redc6t/Sentinel/Hardware/BTTM_v1.2_BOM.xlsx

Qty | Description | Designators | Package | Value | MPN | Manufacturer | Comments
ICs
1 | IC REG BUCK 3.3V 3.5A 20SWTQFN | U1 | 21-100318A_T2044Y+5C_MXM |  | MAX25223ATPB/VY+ | Analog Devices Inc.
1 | RF TXRX MOD BT WIFI PCB TH SMD | U2 | 41-SMD Module |  | ESP32-S3-WROOM-2-N16R8V | Espressif Systems | DNP
1 | IC TRANSCEIVER HALF 1/1 8SOIC | U3 | 8-SOIC |  | TCAN3413DR | Texas Instruments
1 | RF RCVR GNSS/GPS 1.575GHZ 24LCC | U4 | 24-SMD Module |  | NEO-M8M-0 | uBlox | DNP
Capacitors
2 | CAP CER 2.2UF 50V X7R 1206 | C1, C2 | CAPC3216 (1206) | 2.2uF | GCJ31CR71H225KA12L | Murata
4 | CAP CER 0.1UF 100V X7R 0603 | C3, C13, C14, C18 | CAPC1608 (0603) | 100nF | GRM188R72A104KA35D | Murata
2 | CAP CER 1UF 10V X5R 0603 | C4, C15 | CAPC1608 (0603) | 1uF | GRM188R61A105KA61D | Murata
2 | CAP CER 22UF 10V X7R 1206 | C5, C6 | CAPC3216 (1206) | 22uF | GRM31CR71A226KE15L | Murata
4 | CAP ALUM 100UF 20% 6.3V SMD | C7, C8, C9, C10 | Radial, Can - SMD (6.30 x 5.80) | 100u - 35V | EEE-FP0J101AP | Panasonic
1 | CAP CER 10UF 6.3V X5R 0603 | C16, C19 | CAPC1608 (0603) | 10uF | GRM188R60J106KE47D | Murata
1 | CAP CER 10000PF 100V X7R 0603 | C17 | CAPC1608 (0603) | 10nF | GRM188R72A103KA01D | Murata
Resistors
2 | RES 1K OHM 1% 1/10W 0603 | R1, R13 | RCL_R0603 | 1k | RC0603FR-071KL | Yageo
10 | RES 10K OHM 1% 1/10W 0603 | R2, R3, R4, R5, R6, R7, R14, R15, R16, R17 | RCL_R0603 | 10k | RC0603FR-0710KL | Yageo
2 | RES 4.7K OHM 1% 1/10W 0603 | R8, R9 | RCL_R0603 | 4.7k | RC0603FR-074K7L | Yageo
2 | RES 0 OHM 1% 1/10W 0603 | R10, R11 | RCL_R0603 | 0R | RC0603FR-070RL | Yageo
1 | RES 10 OHM 1% 1/10W 0603 | R12 | RCL_R0603 | 10R | RC0603FR-0710RL | Yageo
Filters, Ferrites, Inductors, Fueses
1 | PTC RESET FUSE 60V 550MA 2018 | F1 | FUSE_SMDF050-2 |  | MF-SMDF050-2 | Bourns Inc.
1 | FIXED IND 8.2UH 2A 180 MOHM SMD | L1 | 2-SMD | 8.20uH | SRP4020TA-8R2M | Bourns Inc.
1 | FIXED IND 27NH 300MA 700MOHM SMD | L2 | 0603 (1608 Metric) | 27.0nH | LRC0603CJ27NGV001T | Johanson Technology Inc.
1 | TRANS NPN 40V 1A SOT-323 | Q1 | SOT-323 |  | PBSS4140U,115 | Nexperia USA Inc.
Mechanical
1 | 3 PINS, PANEL MOUNT,Rear FASTE | J1 | CUI_CDM801-03A-MP-F810-67 |  | CDM801-03A-MP-F810-67 | Same Sky
2 | 4 PINS, PANEL MOUNT,Rear FASTE | J2, J12 | CUI_CDM803-04A-FP-R805-67 |  | CDM803-04A-FP-R805-67 | Same Sky
1 | Micro SD Card Holder Pcb Mount | SD | MICROSD-PUSH-OUT |  |  | AliExpress
1 | CONN U.FL RCPT STR 50 OHM SMD | J21 | U.FL |  | U.FL-R-SMT-1(80) | Hirose Electric Co Ltd
1 | Battery Recharge RTC/SRAM Backup | BT1 | BATTCON-6.8MM | 3V - 5.5 mAh | MS621FE-FL11E | Seiko Instruments | DNP
1 | CONN HEADER SMD 6POS 1.27MM | PROG | Conn Header SMT 6 pos 1.27mm |  | FTSH-103-01-L-DV-TR | Samtec Inc. | DNP
1 | 3.2' Module ILI9341 320*240 SPI | 3.2 DISPLAY |  |  |  | AliExpress | DNP
Diodes, TVSs, Schottkys
1 | DIODE SCHOTTKY 40V 5A SMC | D1 | DIOM7959X261N |  | MBRS540T3G | onsemi
1 | TVS DIODE 24VWM 37VC SC703 | D3 | SOT-323 |  | ESD2CAN24DCKRQ1 | Texas Instruments
1 | Single Colour LEDs WL-SMCW SMD | D5 | LED-1206-BOTTOM |  | 150060SS75000 | Wurth Elektronik | Optional
