redc6t/Sentinel/Hardware/Enclosure/Sentinel_Top_Enclosure_1.4.step

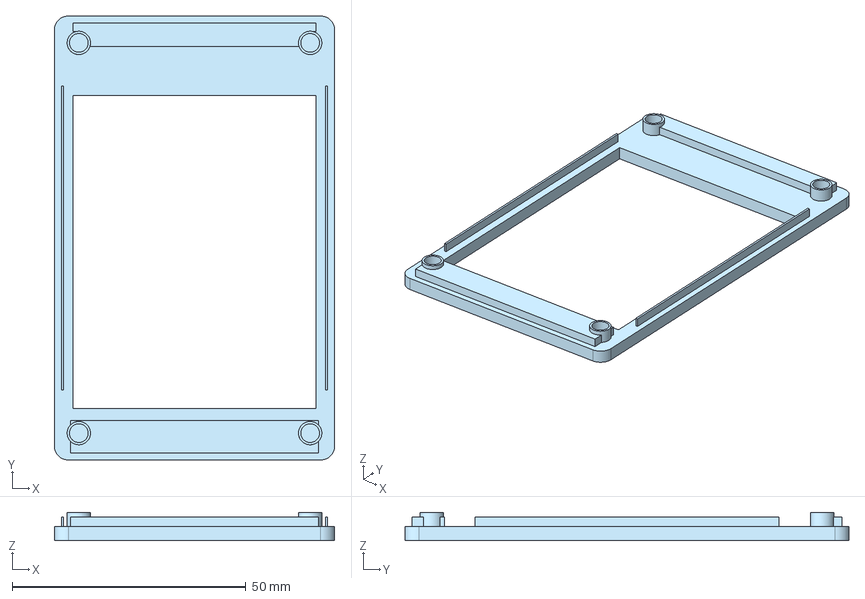
[picture p3: CAD file, 2026-10-24]
Hardware/Enclosure/Sentinel_Top_Enclosure_1.4.step
60.0 x 95.0 x 6.00 mm
