redc6t/Sentinel/Hardware/PCB/3D/BTTM_v1.4.step

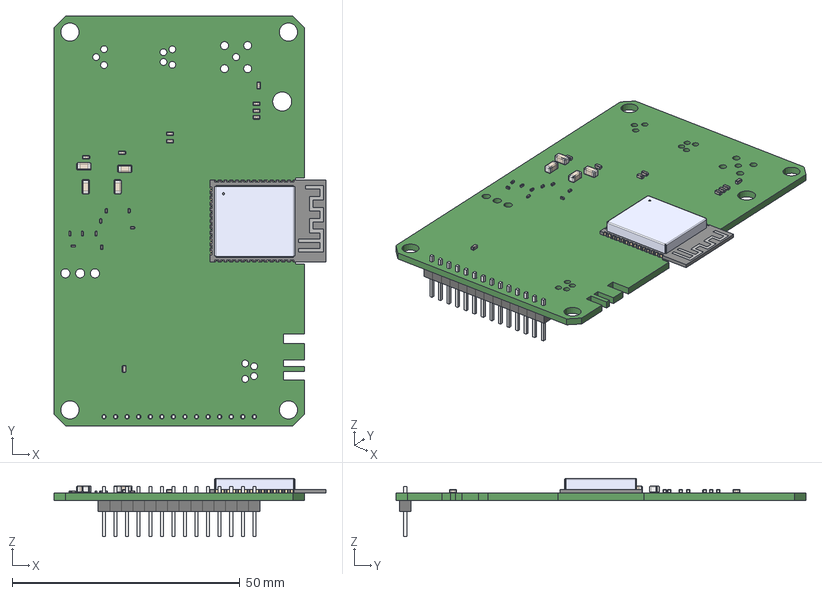
[picture p4: CAD file, 2026-10-17]
Hardware/PCB/3D/BTTM_v1.4.step
59.8 x 90.0 x 12.9 mm
PCB:1
3.2DISPLAY:1
C1:1
C2:1
C3:1
C4:1
C5:1
C6:1
C13:1
C14:1
C15:1
C16:1
C17:1
C18:1
C19:1
C21:1
C22:1
C51:1
C121:1
C122:1
C123:1
C124:1
C125:1
C131:1
U2:1
