redc6t/Sentinel/Hardware/Enclosure/Sentinel_Bottom_Enclosure_1.4.step

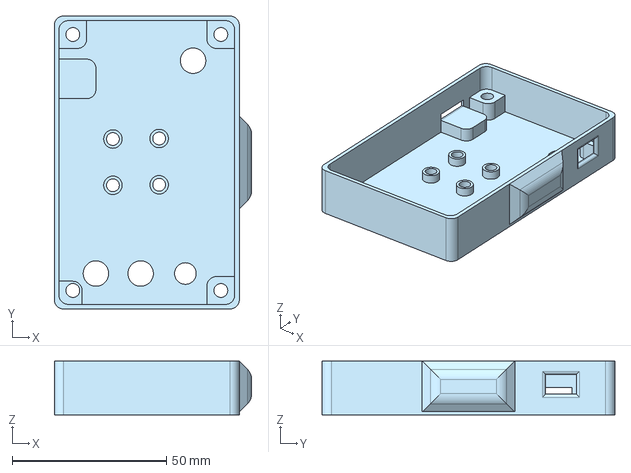
[picture p5: CAD file, 2026-10-24]
Hardware/Enclosure/Sentinel_Bottom_Enclosure_1.4.step
64.0 x 95.0 x 17.4 mm
