redc6t/Sentinel/Photos-Journal_Megadump/7) Full System Install on Alfa Romeo 156/IMG_2208.jpeg

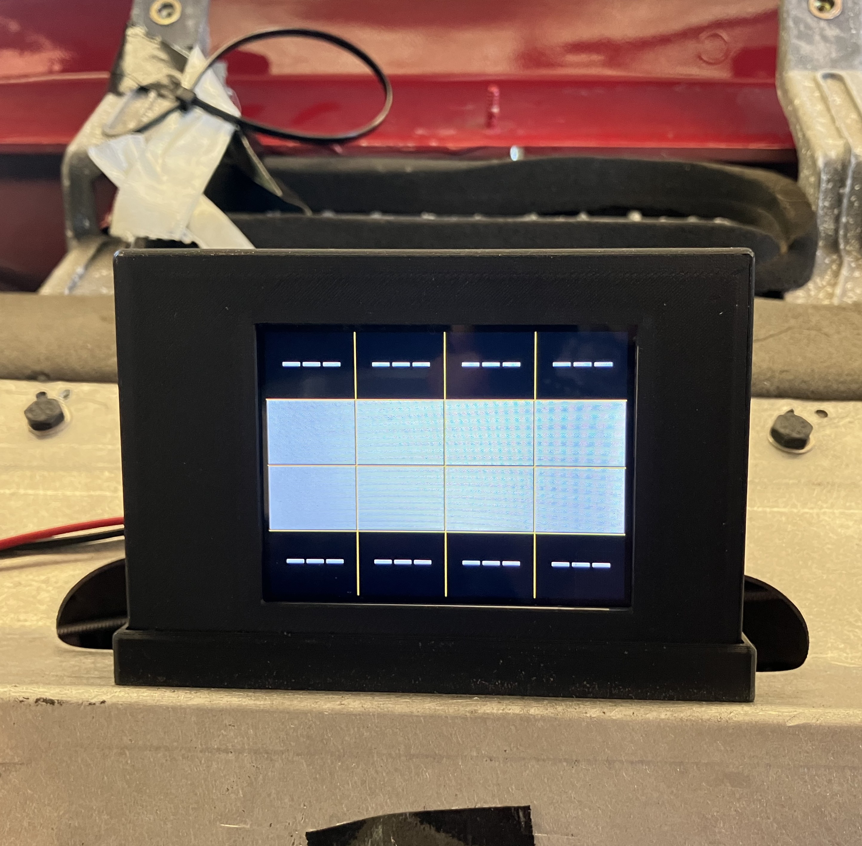
Photos-Journal_Megadump/7) Full System Install on Alfa Romeo 156/IMG_2208.jpeg
