redc6t/Sentinel/Photos-Journal_Megadump/8) 1.4 version photoshoot/IMG_3616.jpeg

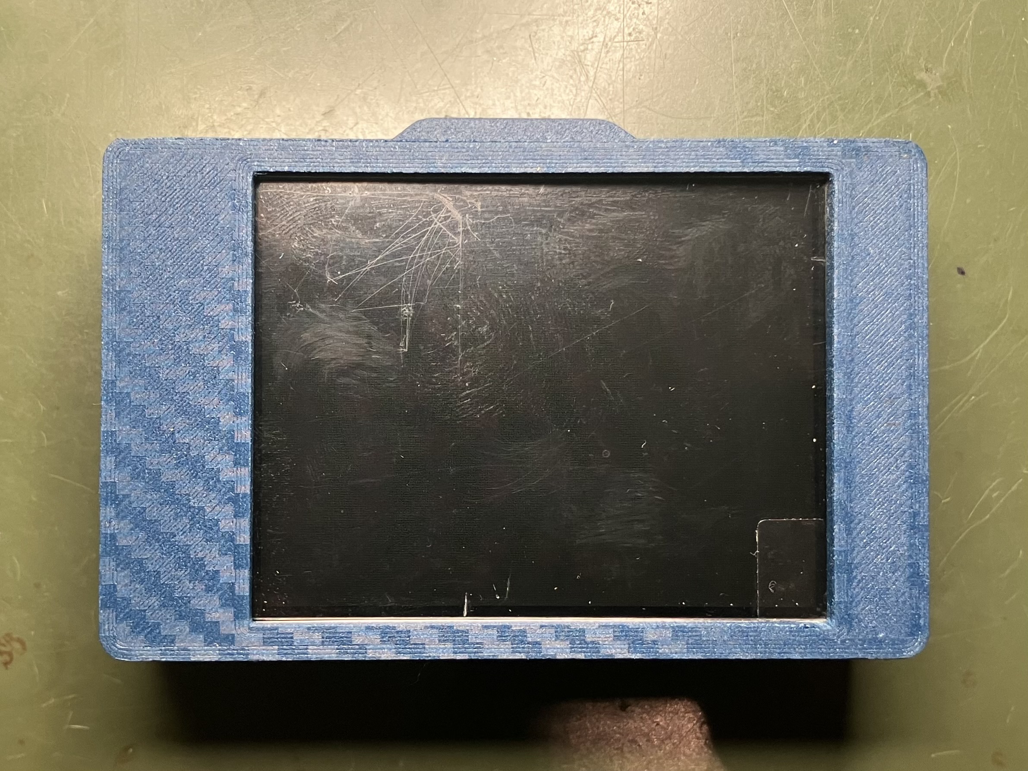
Photos-Journal_Megadump/8) 1.4 version photoshoot/IMG_3616.jpeg
