redc6t/Sentinel/Hardware/PCB/Board/BTTM_v1.4_Board.pdf

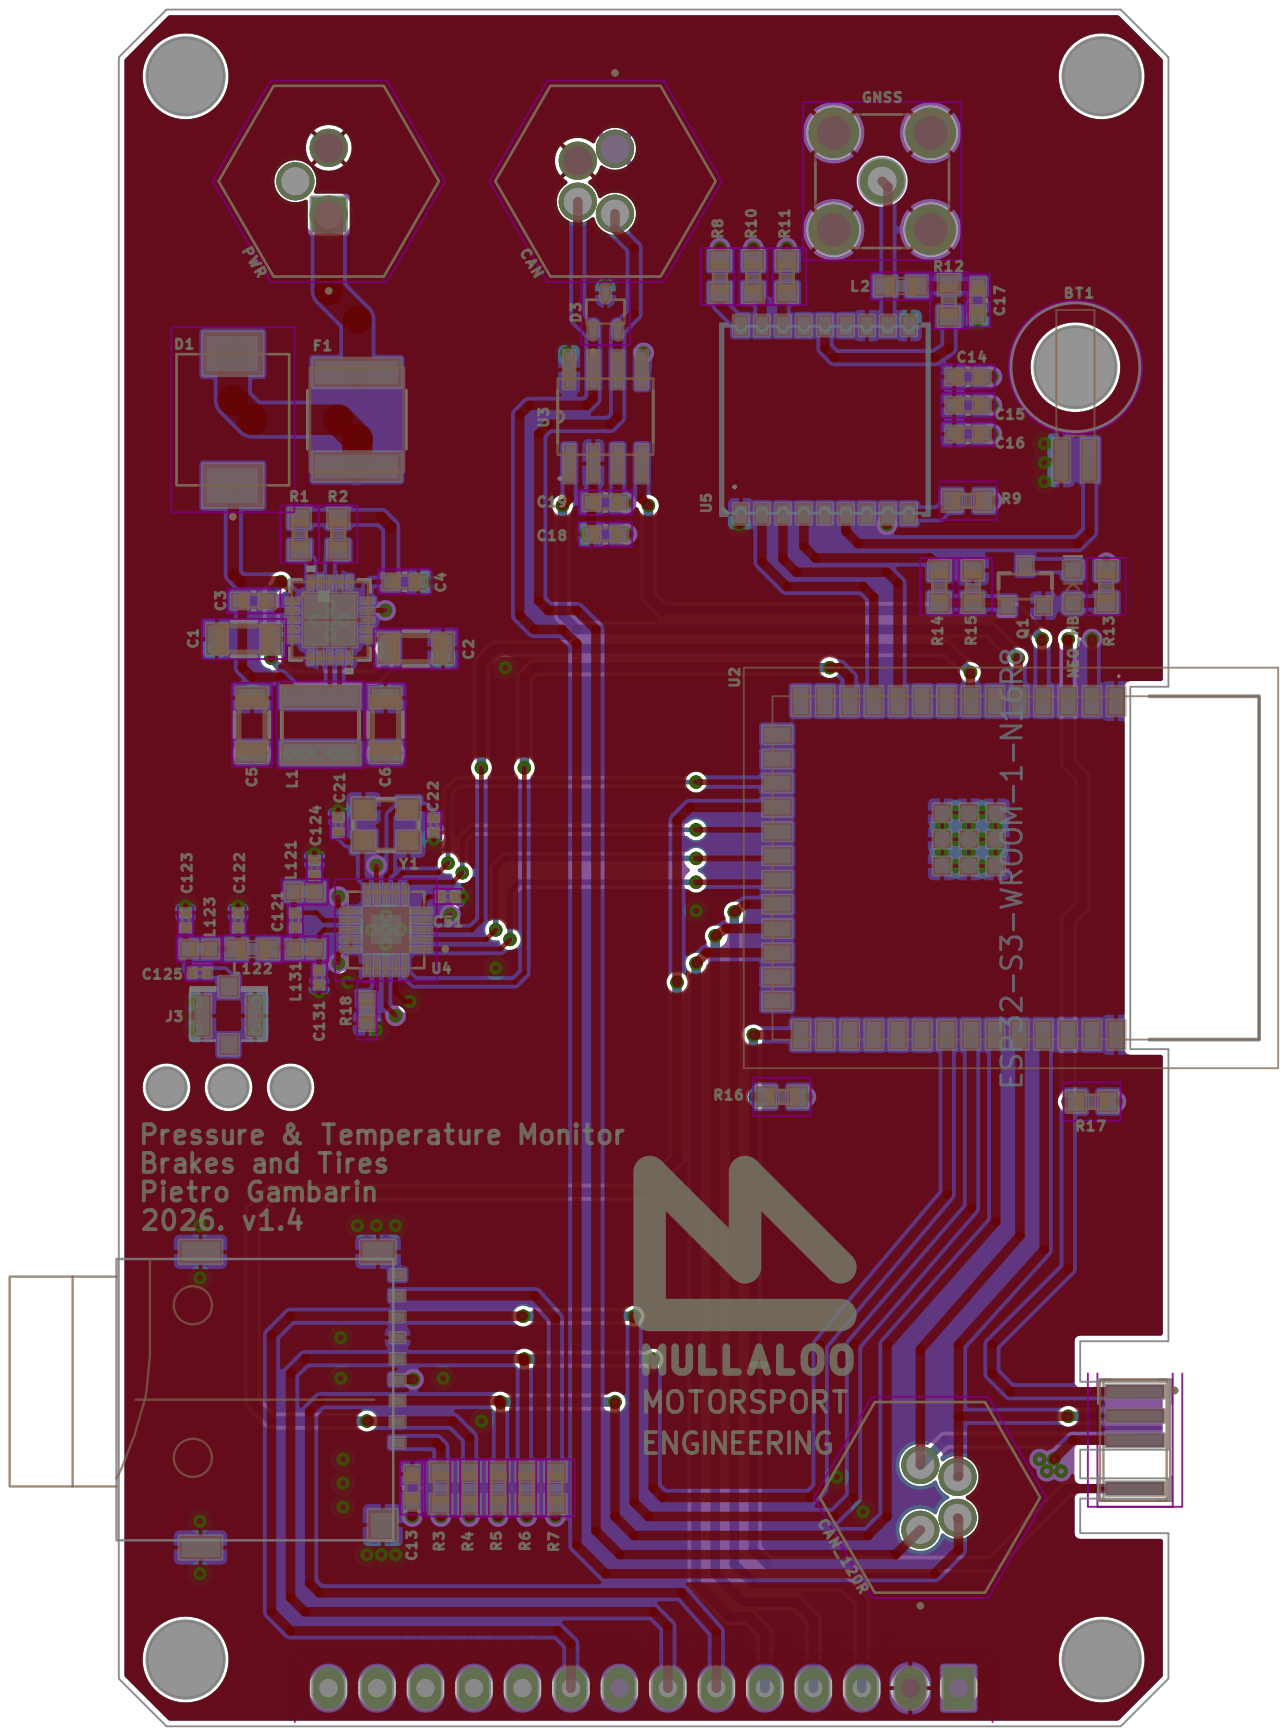
[picture p11: page 1]

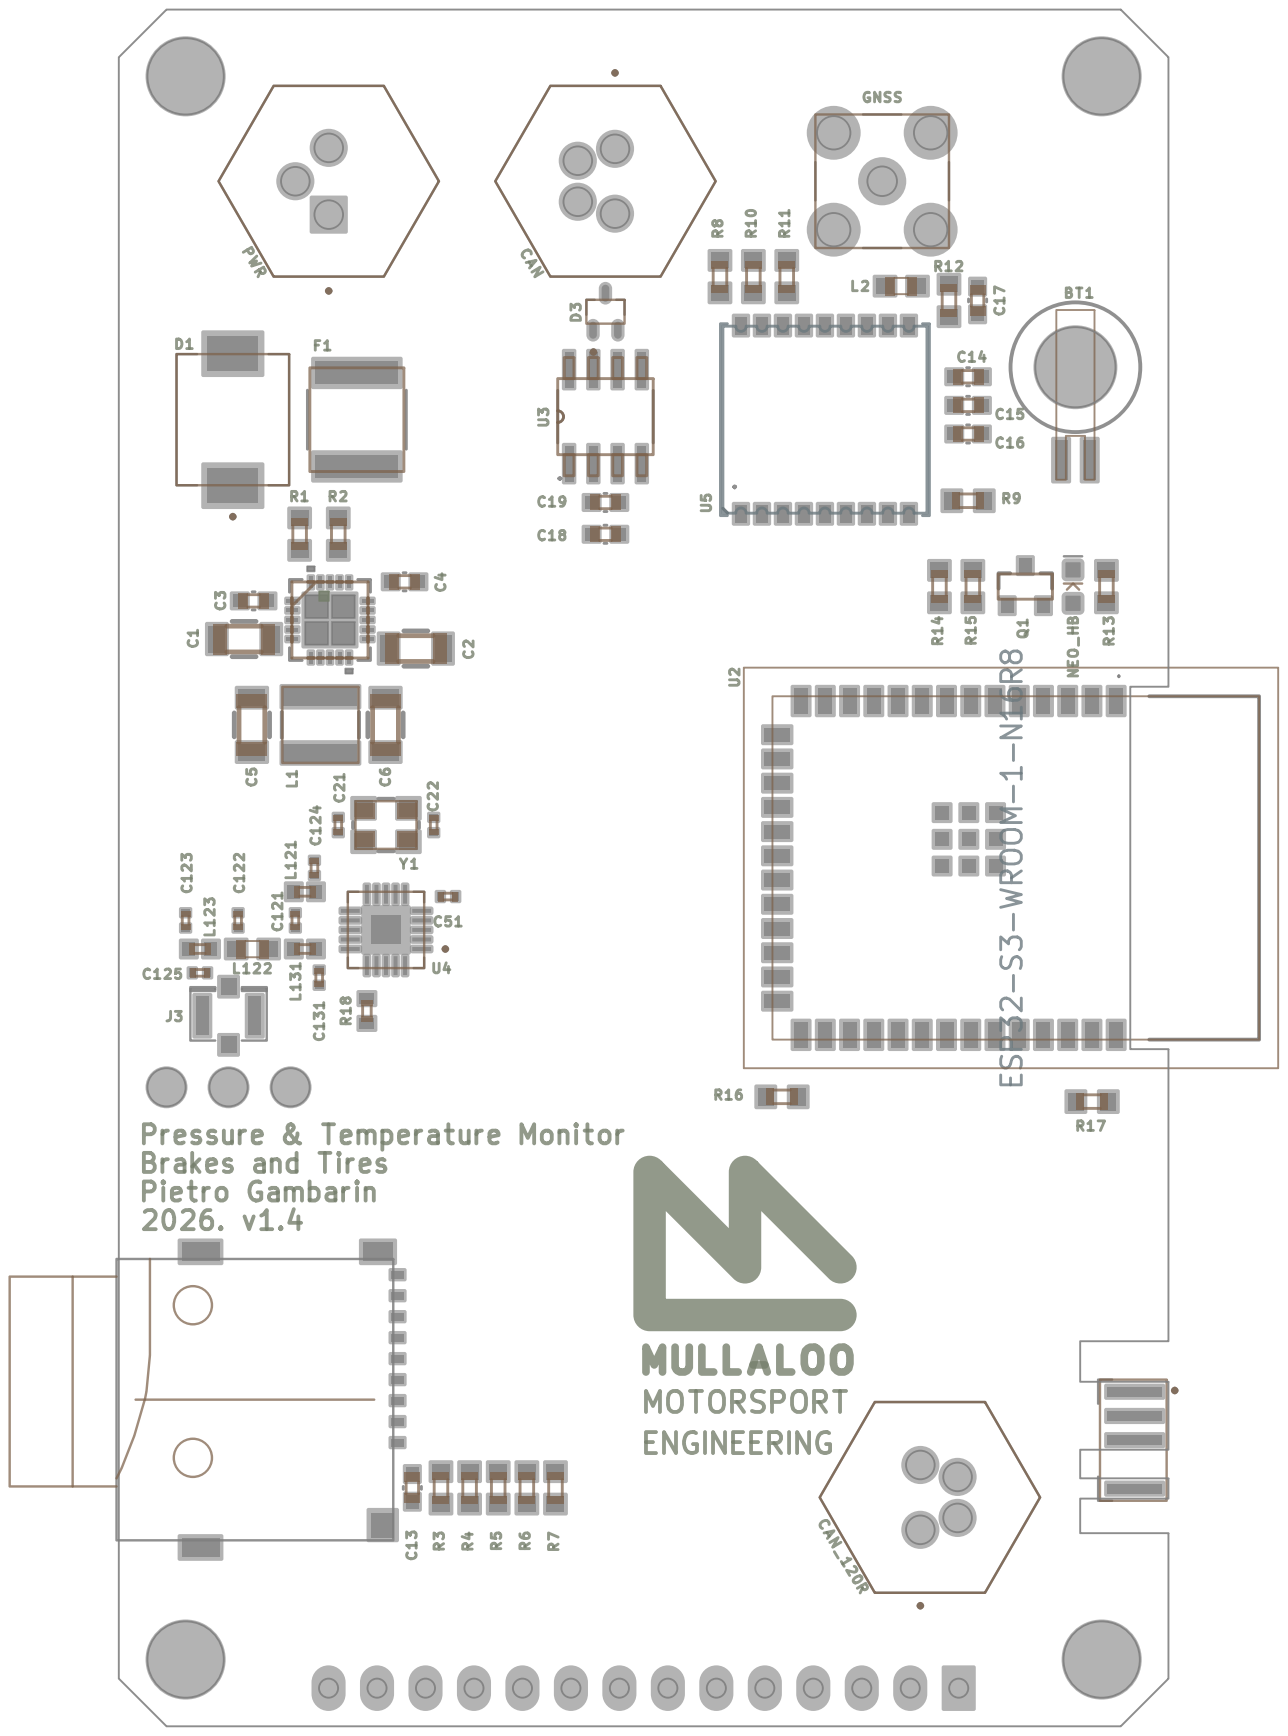
[picture p12: page 2]

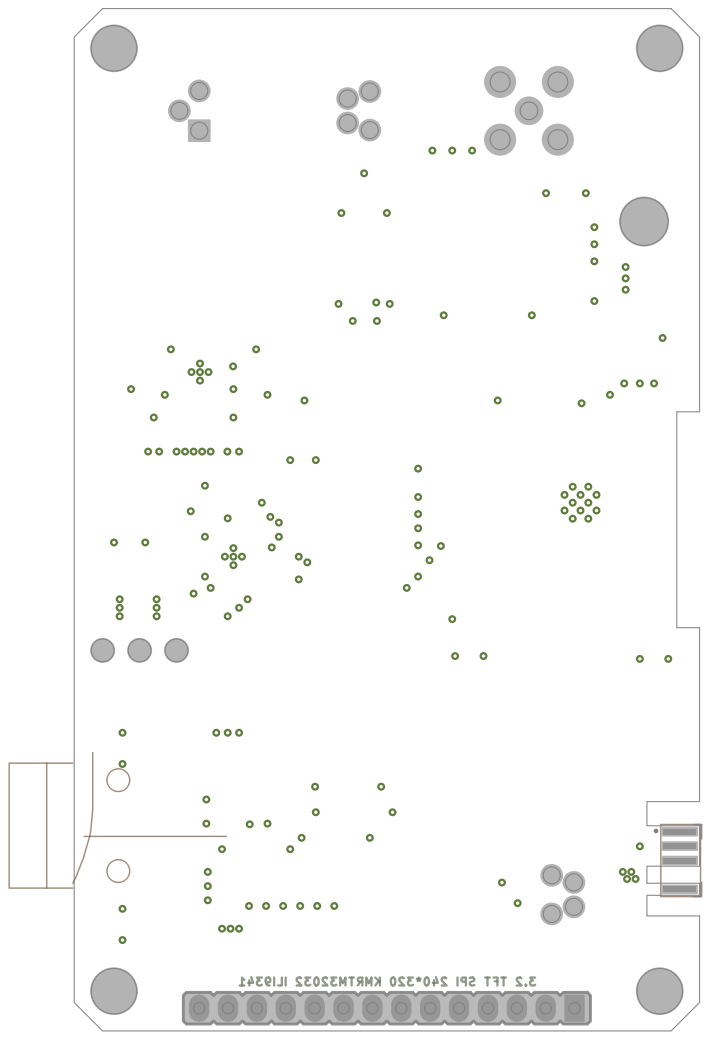
[picture p13: page 3]
3.2 TFT SPI 240*320 KMRTM32032 ILI9341

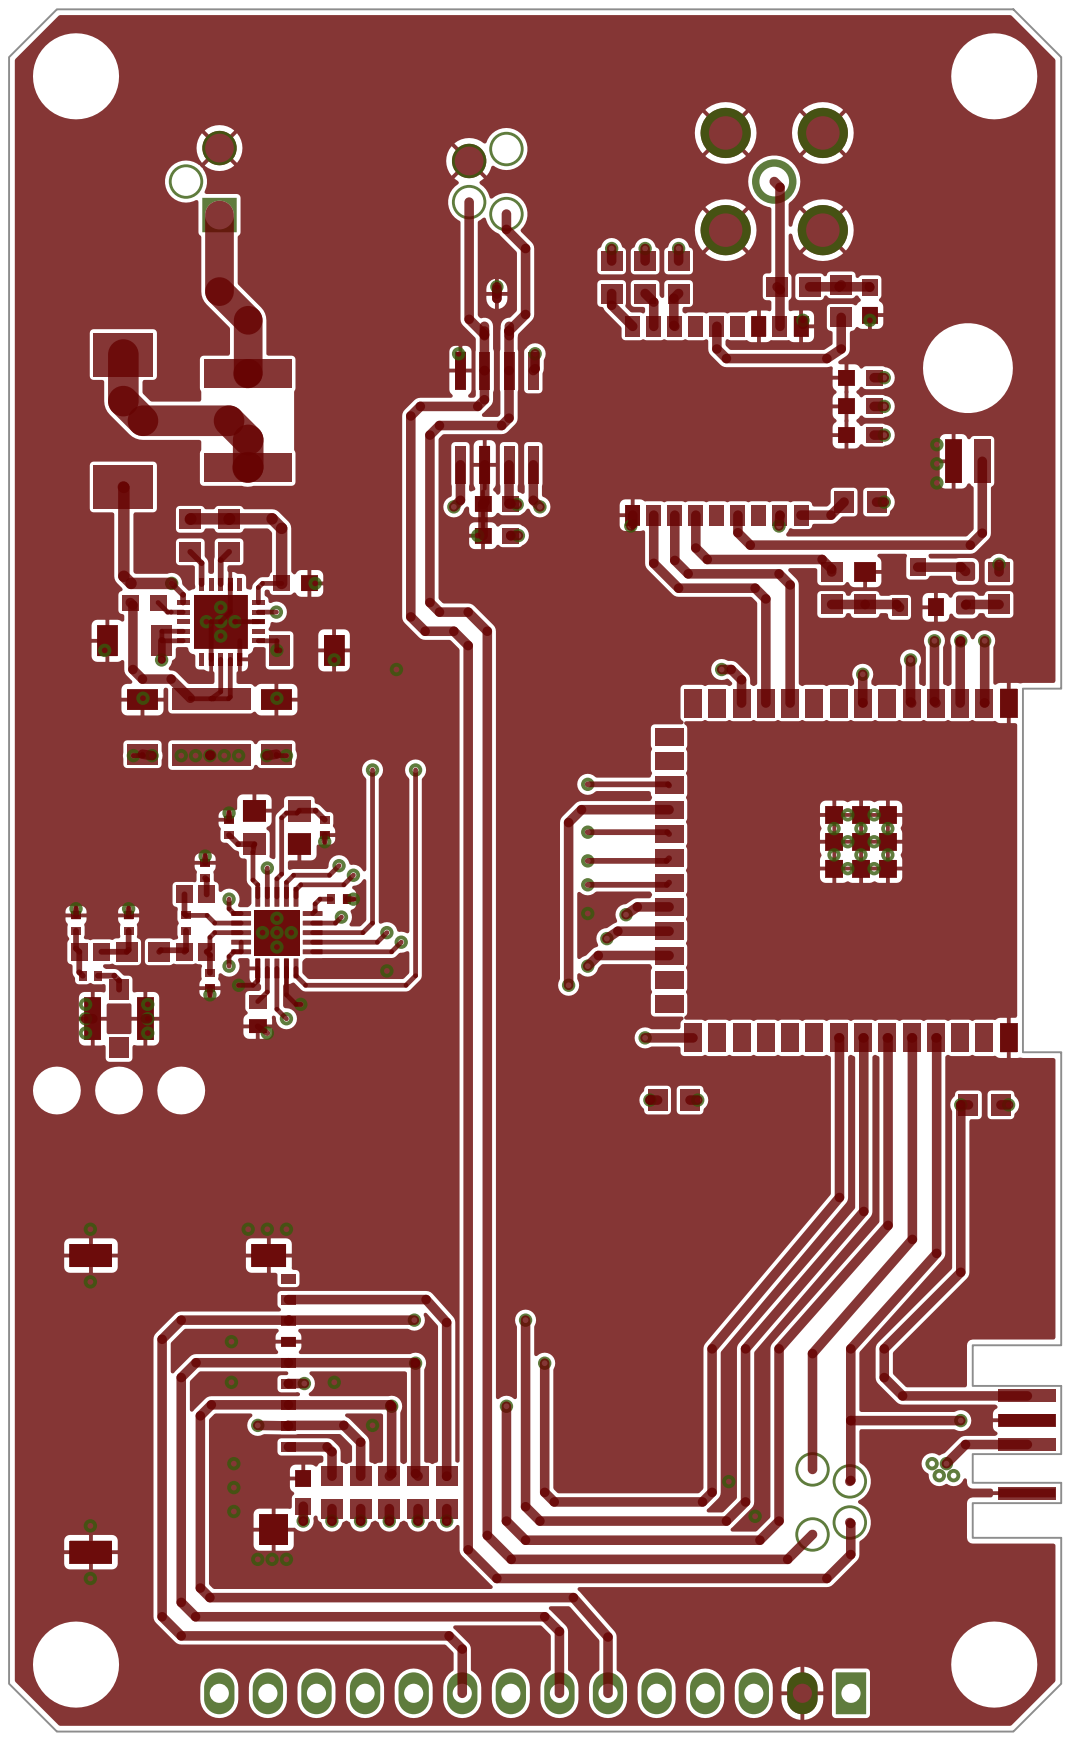
[picture p14: page 4]

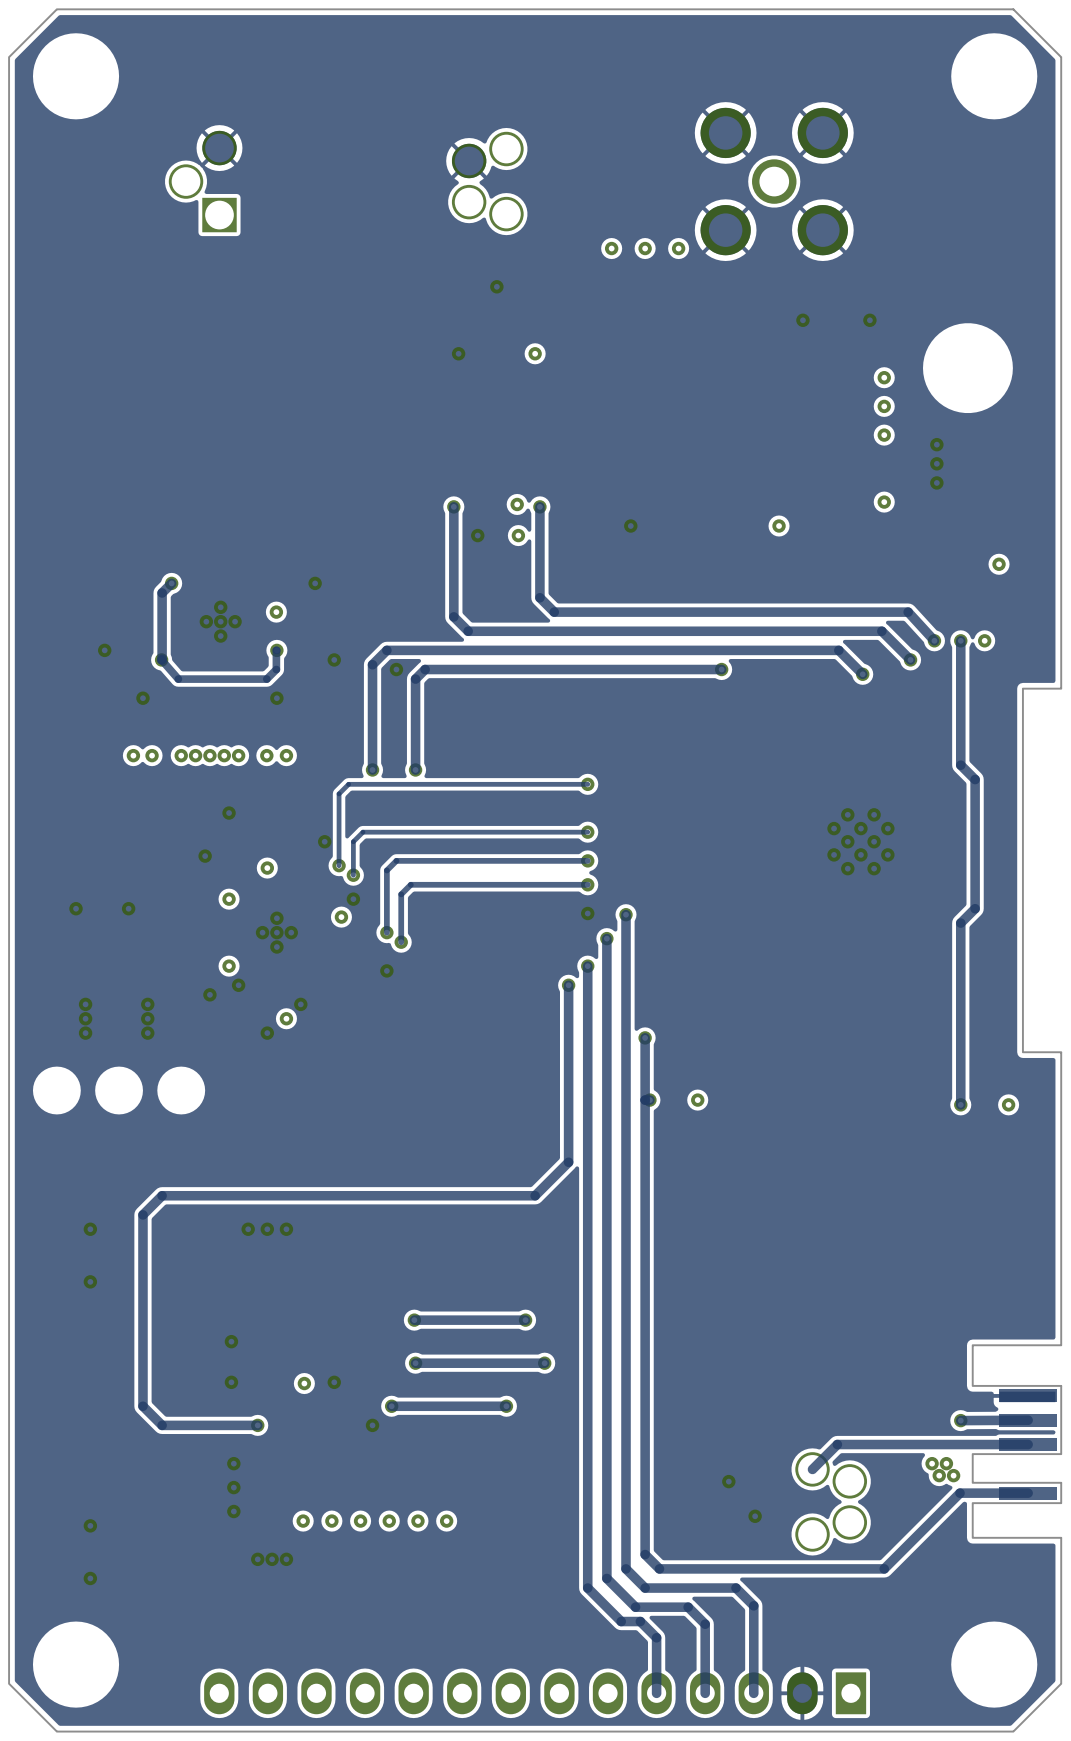
[picture p15: page 5]
