redc6t/Sentinel/Hardware/PCB/Schematic/BTTM_v1.4_Schematic.pdf

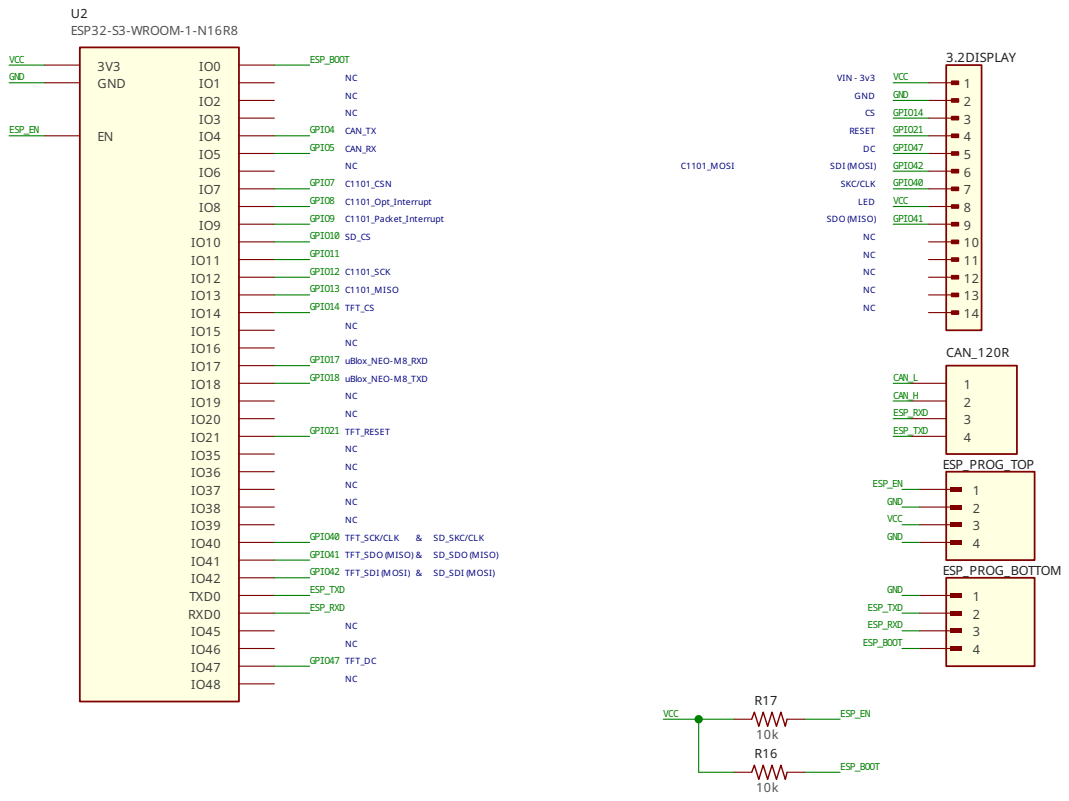
[picture p16: page 1]

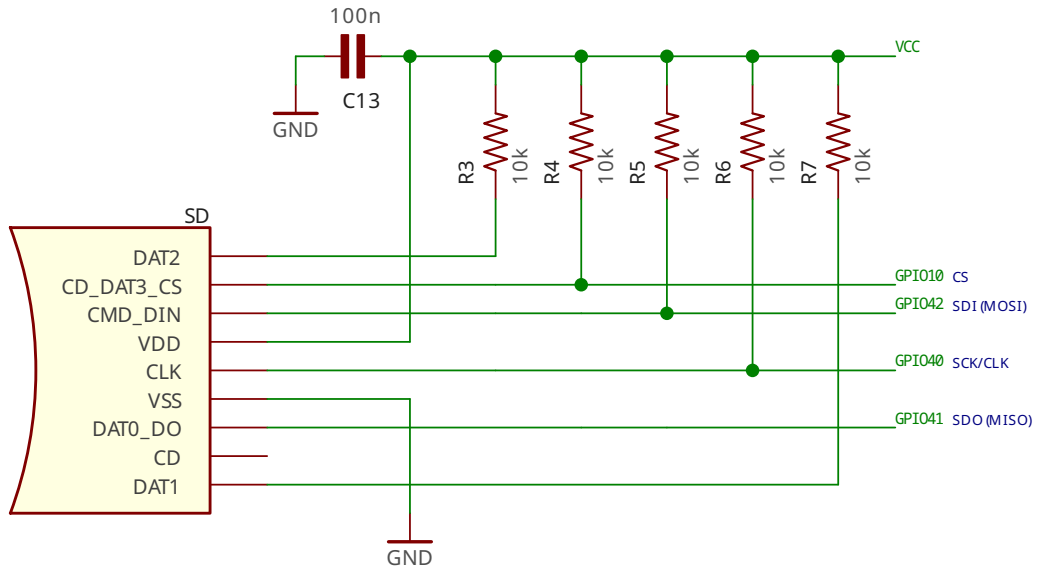
[picture p17: page 2]
uSD (SPI) BTTM v.1.0; Rev: 1.0; Pietro Gambarin; SDI (MOSI); SDO (MISO)

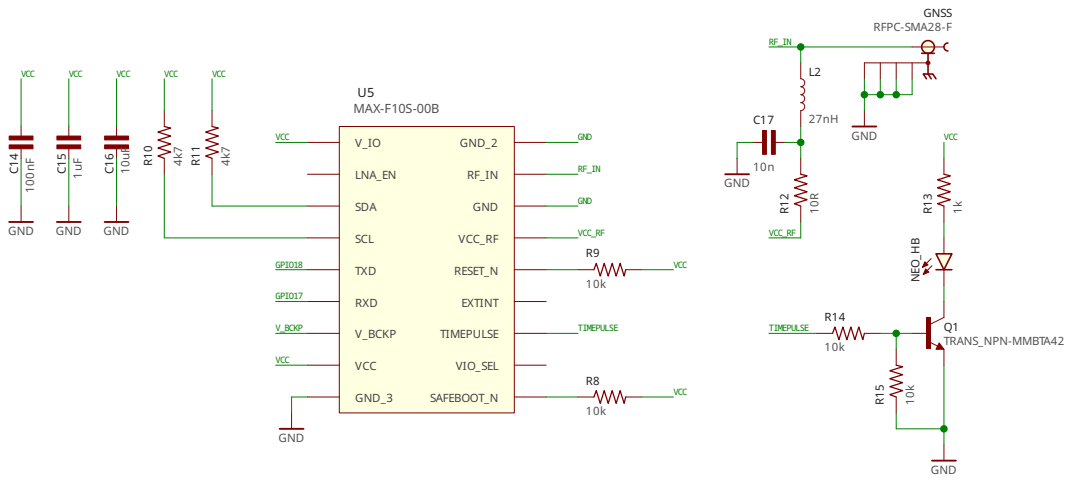
[picture p18: page 3]

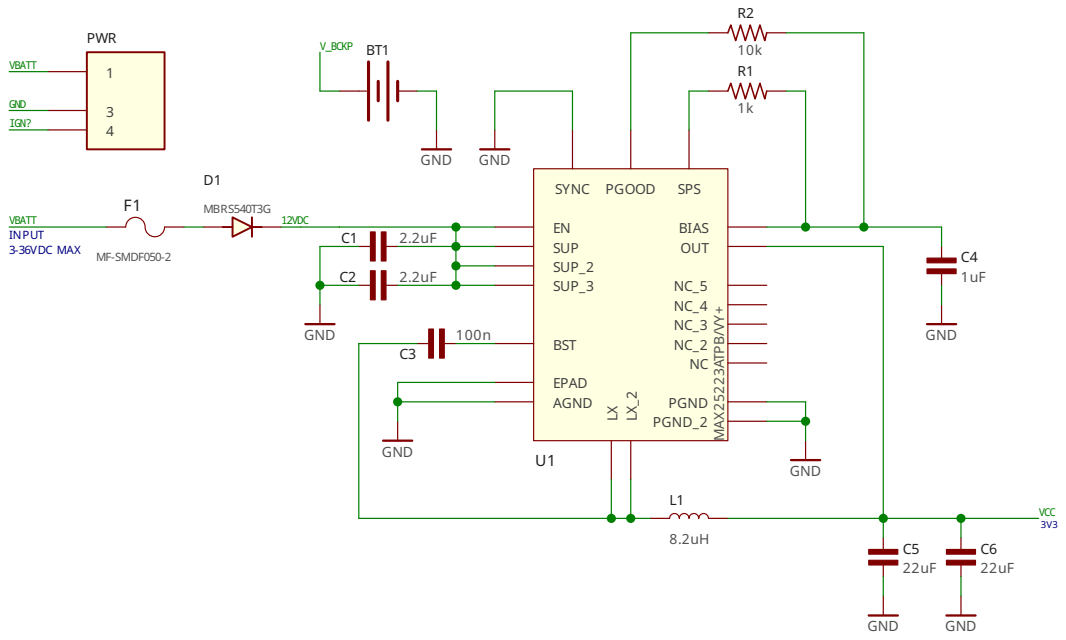
[picture p19: page 4]

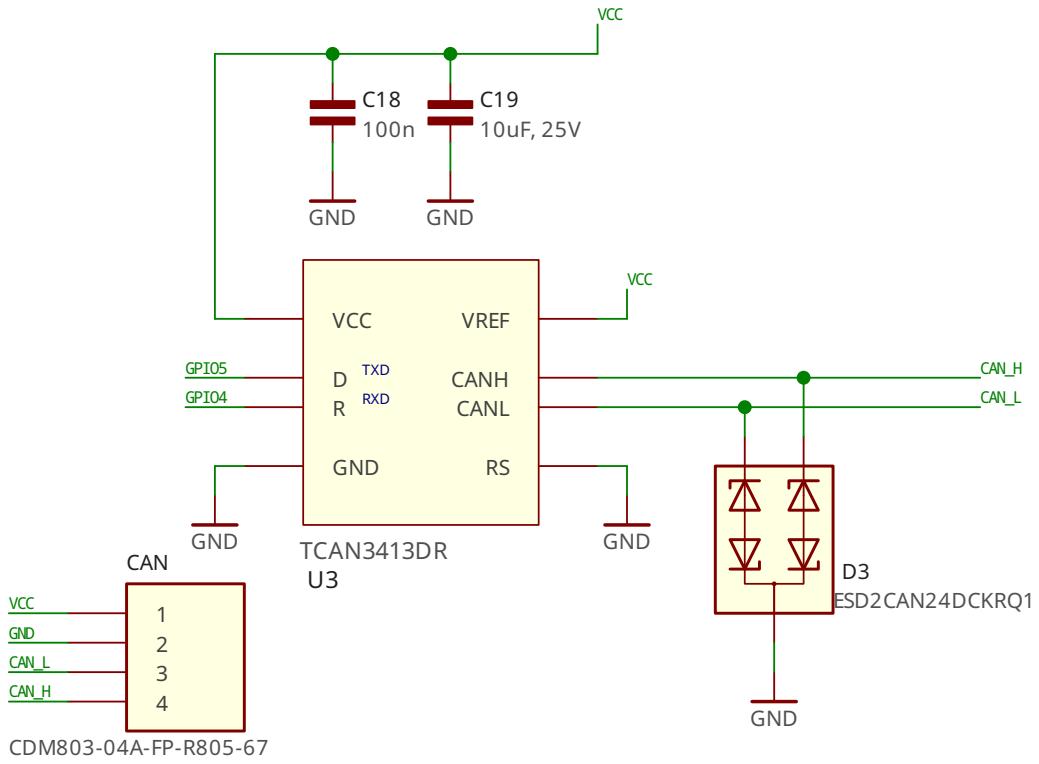
[picture p20: page 5]
CAN RX/TX BTTM v.1.0; Rev: 1.0; Pietro Gambarin

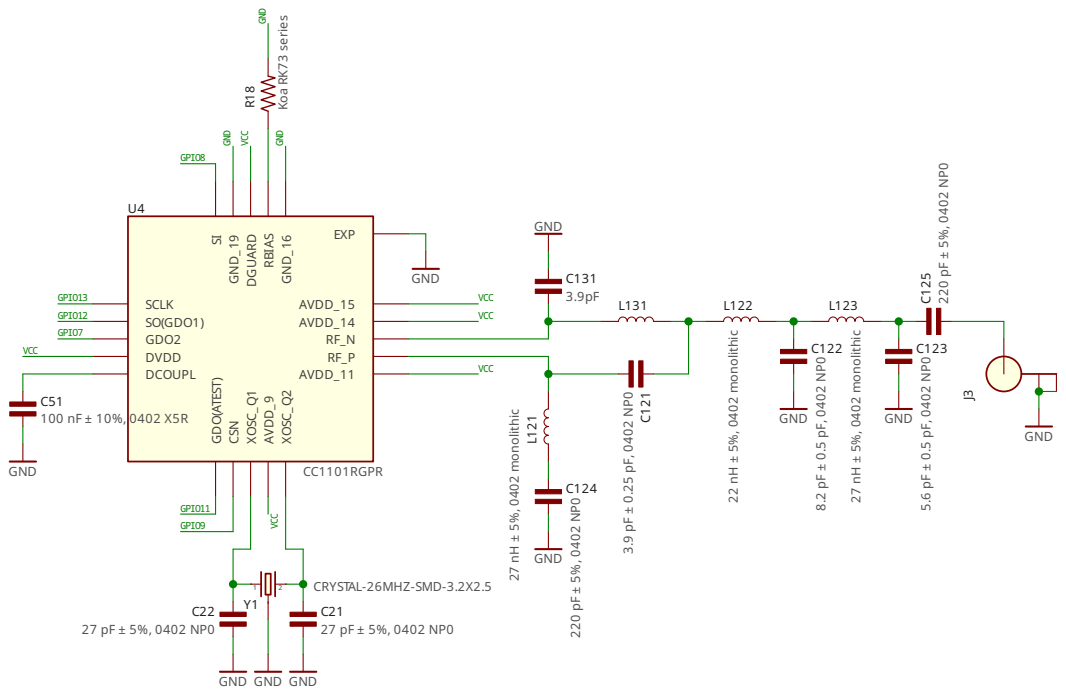
[picture p21: page 6]
