redc6t/Sentinel/Hardware/BTTM_v1.2_Schematic_Print.pdf

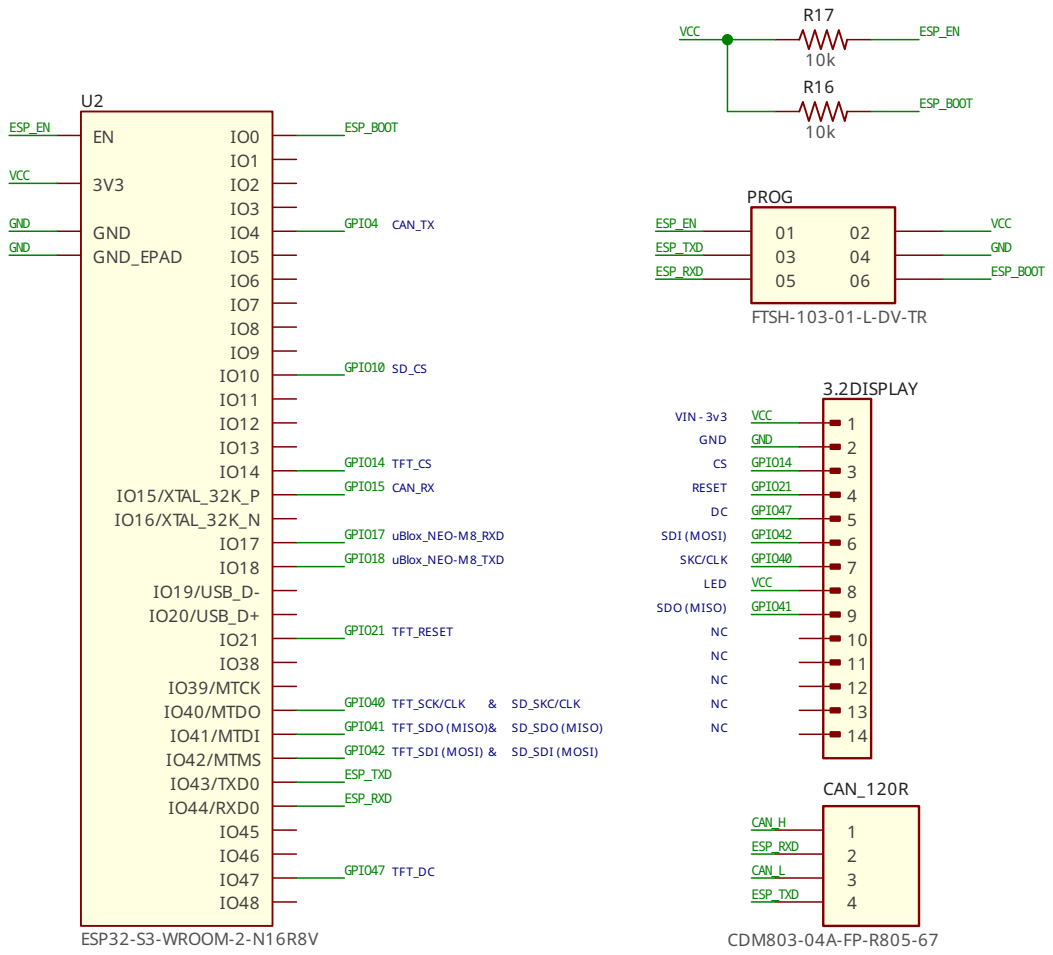
[picture p22: page 1]
BTTM v.1.0; Rev: 1.0; Pietro Gambarin; SDO (MISO); uBlox_NEO-M8_RXD; SDI (MOSI); SD_SDI (MOSI); SD_SDO (MISO); TFT_SDO (MISO); VIN - 3v3; TFT_SDI (MOSI)

FTSH-103-01-L-DV-TR

MCU & TFT DISPLAY

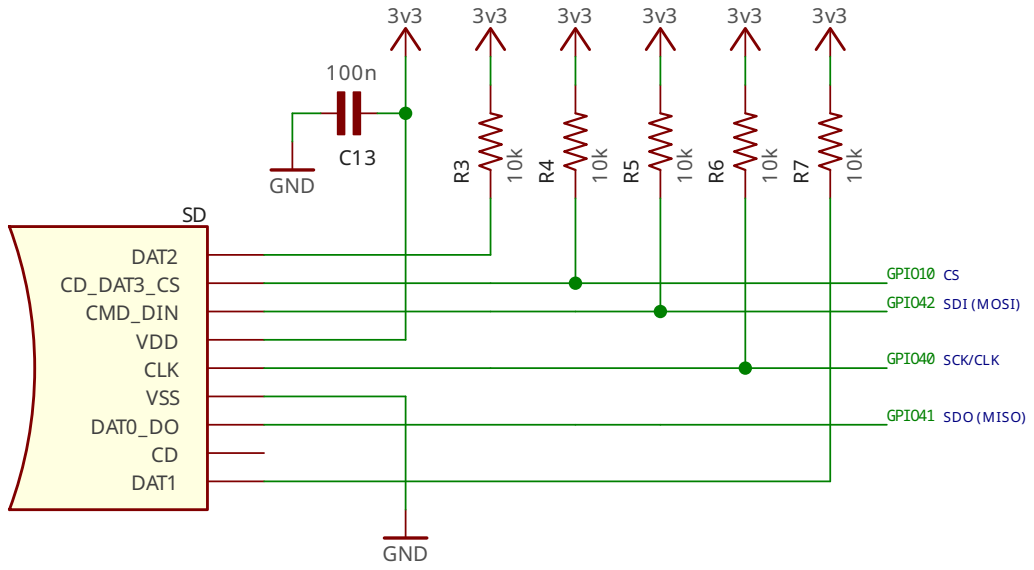
[picture p23: page 2]
uSD (SPI); BTTM v.1.0; Pietro Gambarin; SDI (MOSI); SDO (MISO)

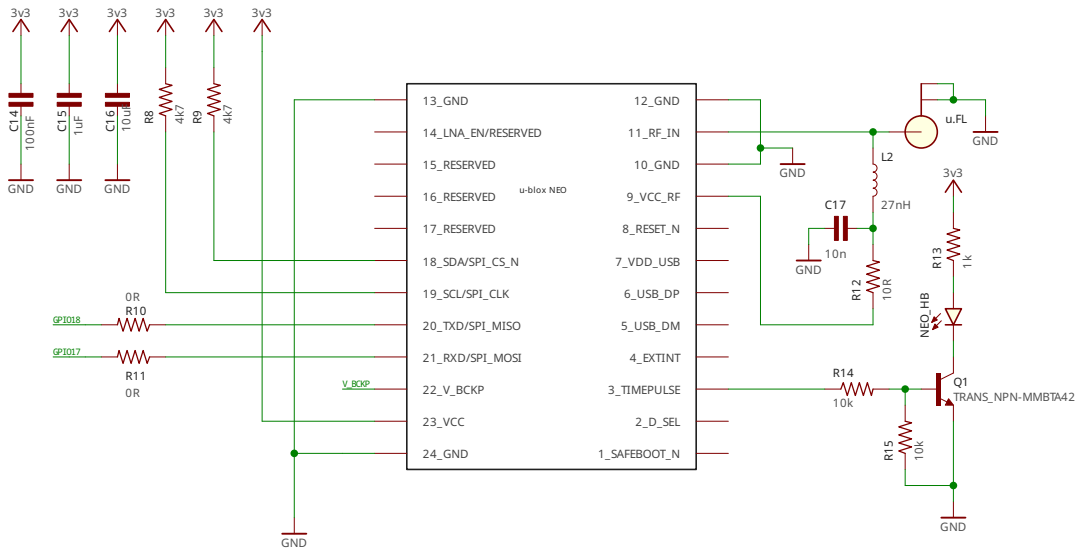
[picture p24: page 3]

u-blox NEO M8 GNSS Module

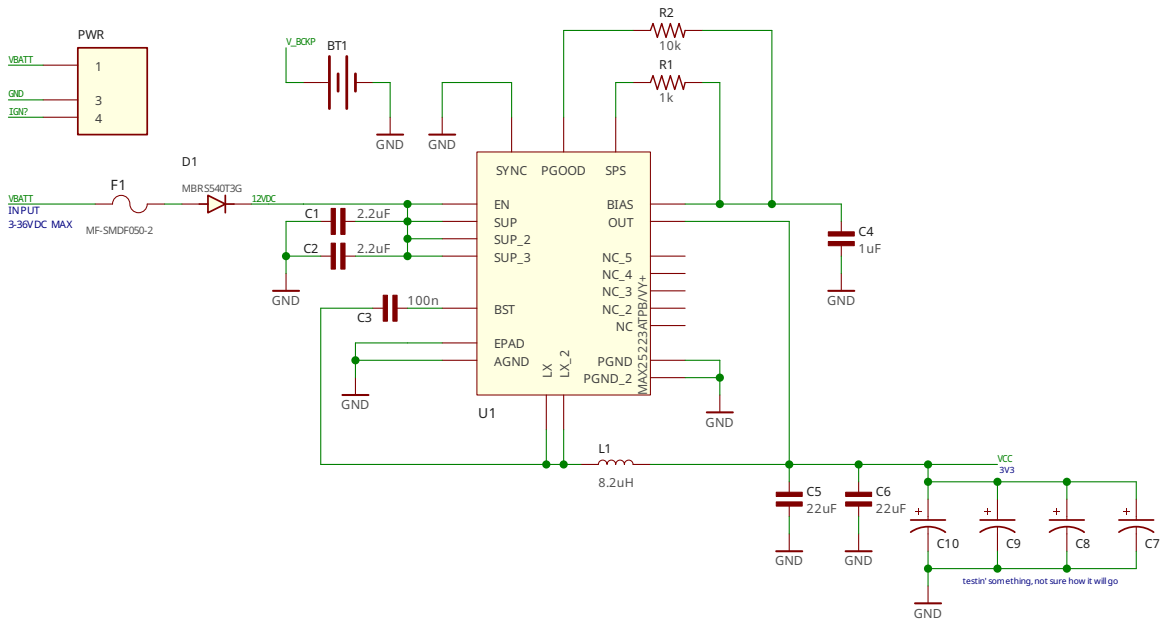
[picture p25: page 4]

testin' something,not sure how it willgo

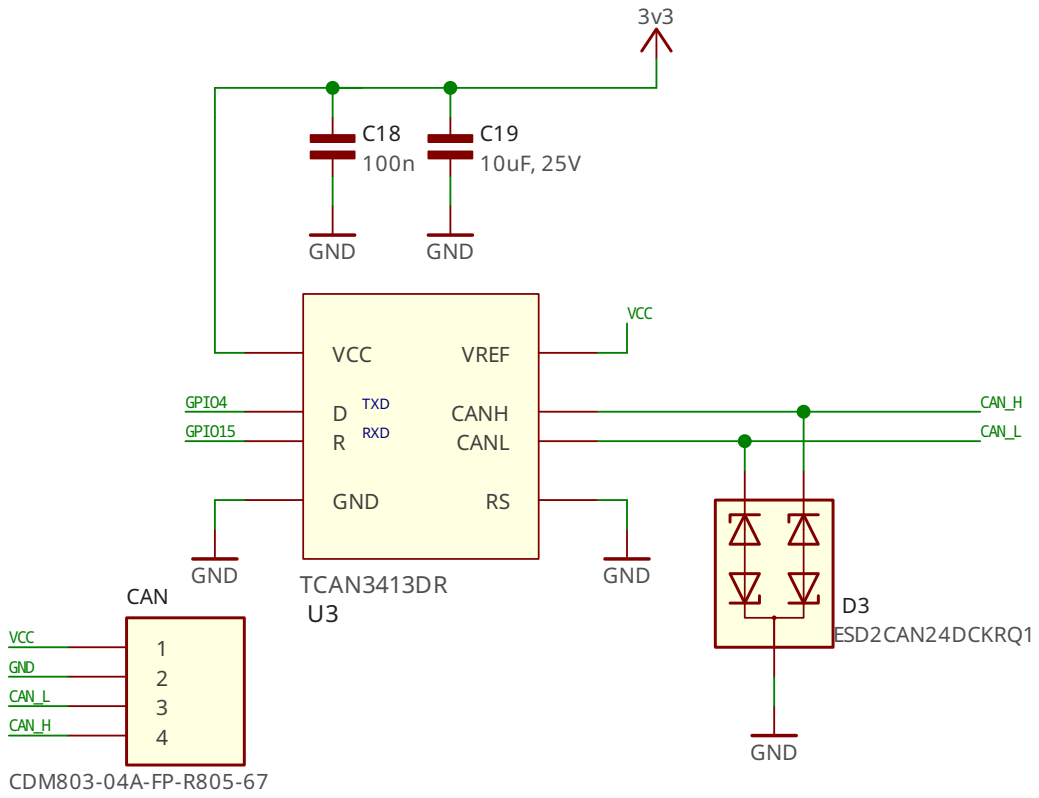
[picture p26: page 5]
BTTM v.1.0; Pietro Gambarin

CAN RX/TX
