redc6t/Sentinel/(commit log)

2026-01-30 Update hardware files to v1.2
    Removed v1.1 PCB and schematic PDFs, added v1.2 versions, and renamed BOM file to reflect v1.2. This updates documentation to the latest hardware revision.
2026-02-14 Add BTTM CAN loop diagrams, PCB changelog, photos
    Add Documentation/Flowchart BTTM_Cirle_CAN_Loop.drawio and its backup, include Hardware/pcb_changelog.txt, and add photos documenting the full system install on an Alfa Romeo 156 under Photos-Journal_Megadump/7) Full System Install on Alfa Romeo 156 (IMG_2204.jpeg, IMG_2205.jpeg, IMG_2206.jpeg, IMG_2208.jpeg). These assets provide the CAN loop flowchart, PCB revision notes, and installation imagery for reference.
2026-10-17 Rename product from BTTM to Sentinel
    Sentinel - Brake & Tyre Temperature & Pressure Monitor.
    - README, LICENSE and hardware changelog: new name and tagline
    - Restore BTTM board history in pcb_changelog.txt (the PLTD template had
    overwritten it) and rename entries to Sentinel
    - Rewrite Hardware/README.md for Sentinel: Sentinel_vX.Y_* naming,
    v1.4 core components, CC BY-SA 3.0
    - Rename CAN loop and flowchart draw.io sources and the v1.9.1
    pseudocode to Sentinel_*; update diagram labels
    - Spell "tyre" consistently across docs and pseudocode
    - Remove committed draw.io autosave and ignore .$*.bkp
    - Drop v1.2 BOM and print PDFs from Hardware/ (to be restored under
    Fabrication/v1.2/); add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
2026-10-17 Add photos to v1.4 photoshoot
    Add three images (IMG_3615–IMG_3617) to the v1.4 photoshoot collection.
2026-10-24 Ignore local-only Sauce firmware folder
    Add Sauce/ to .gitignore to match the Agile repo. The folder holds local-only firmware backups (currently BTTM_v4_6_0.txt, the current v4.6.0 source) and is never pushed.
